Ammar-Wahidi/Solar-Tracker/(list of files, drawings)

Other design files:
Small Circuits alone/Design2fordifference.ms14
Small Circuits alone/Divide_Voltage_High_Current.ms14
